brianlevis/nerf-iron-dome/images/labeled_board.jpg

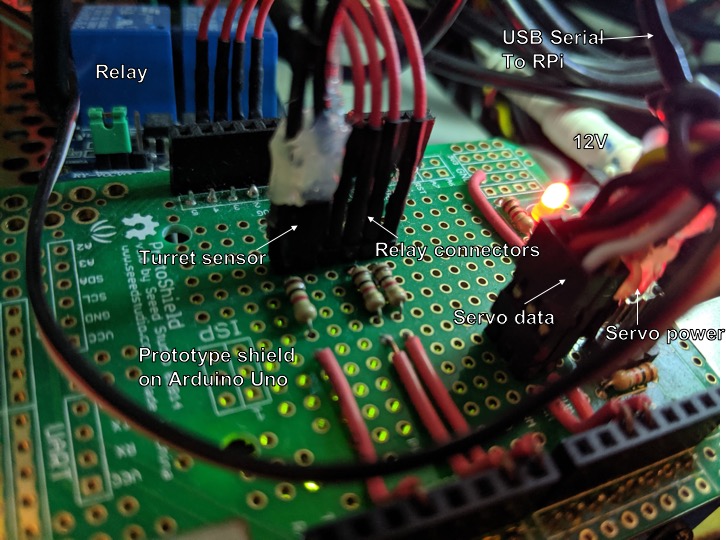
images/labeled_board.jpg
