brianlevis/nerf-iron-dome/cad/Assembly v7.png

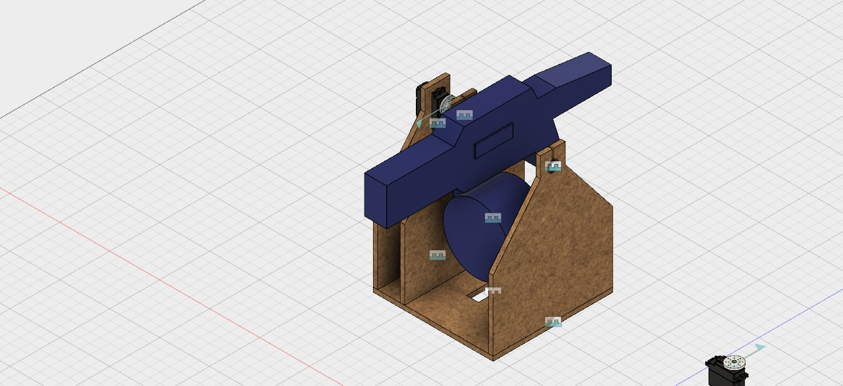
cad/Assembly v7.png
