brianlevis/nerf-iron-dome/camera_pi.py

"""
Python interface for the raspberry pi camera, for use in the web server.
"""

import io
import time
import picamera
from base_camera import BaseCamera


class Camera(BaseCamera):
    @staticmethod
    def frames():
        with picamera.PiCamera() as camera:
            # flip camera output vertically
            camera._set_vflip(True)
            # let camera warm up
            time.sleep(2)

            stream = io.BytesIO()
            for _ in camera.capture_continuous(stream, 'jpeg',
                                                 use_video_port=True):
                # return current frame
                stream.seek(0)
                yield stream.read()

                # reset stream for next frame
                stream.seek(0)
                stream.truncate()
