brianlevis/nerf-iron-dome/(commit log)

2017-05-24 initial commit of arduino test stuff
2017-05-24 init detect/track commit
2017-05-28 gun no longer goes crazy on reset, added serial control
    [GunController.ino]
2017-06-04 updated ino for servos & serial-only control
2017-06-05 fixed errors for arduino-mk
    [GunController.ino]
2017-06-08 Revert "clean up python files"
    This reverts commit dbbf375ec370d463a4976615f9c5d6929e56f976.
    [server.py]
2017-06-19 Semi-automatic controller support, stops working after a few minutes, auto not working
    [GunController.ino, stable_controller_operation.py]
2017-07-06 Add prefix to error reporting, add timeout for firing sensor input
    [GunController.ino]
2017-07-06 Improved errors, wait for acknowledgement message
    [stable_controller_operation.py]
2017-07-06 Updated .gitignore with arduino build directory
2017-08-04 Add link to Python connector design
2017-10-20 Fix pan clock issue
    [GunController.ino, nerf_turret.py]
2017-11-04 add velocity-based control
2018-01-17 added stable velocity-based motion control
2018-01-17 keyboard control and calibration
2018-03-24 adjust keyboard-control timer
2018-03-28 add ball track and patrol
2018-09-22 Fix camera ref
2018-09-22 Update socketio import
2018-09-22 Fix missing socketio
2018-09-22 Flip camera output
2018-09-22 Update flask-socketio in requirements.txt
2018-09-22 Fix cast in debug msg
    [server.py]
2018-09-22 Don't invert y axis
    [server.py]
2018-09-23 Device orientation experiments
2018-09-23 use video capture to avoid calculating the current frame
2018-09-23 switch from dnns to cascades
2019-05-17 add board image
